TakkTile/takktile-boards/takkarray/usbInterface.brd

## EAGLE design takkarray/usbInterface.brd (2013-01-09)

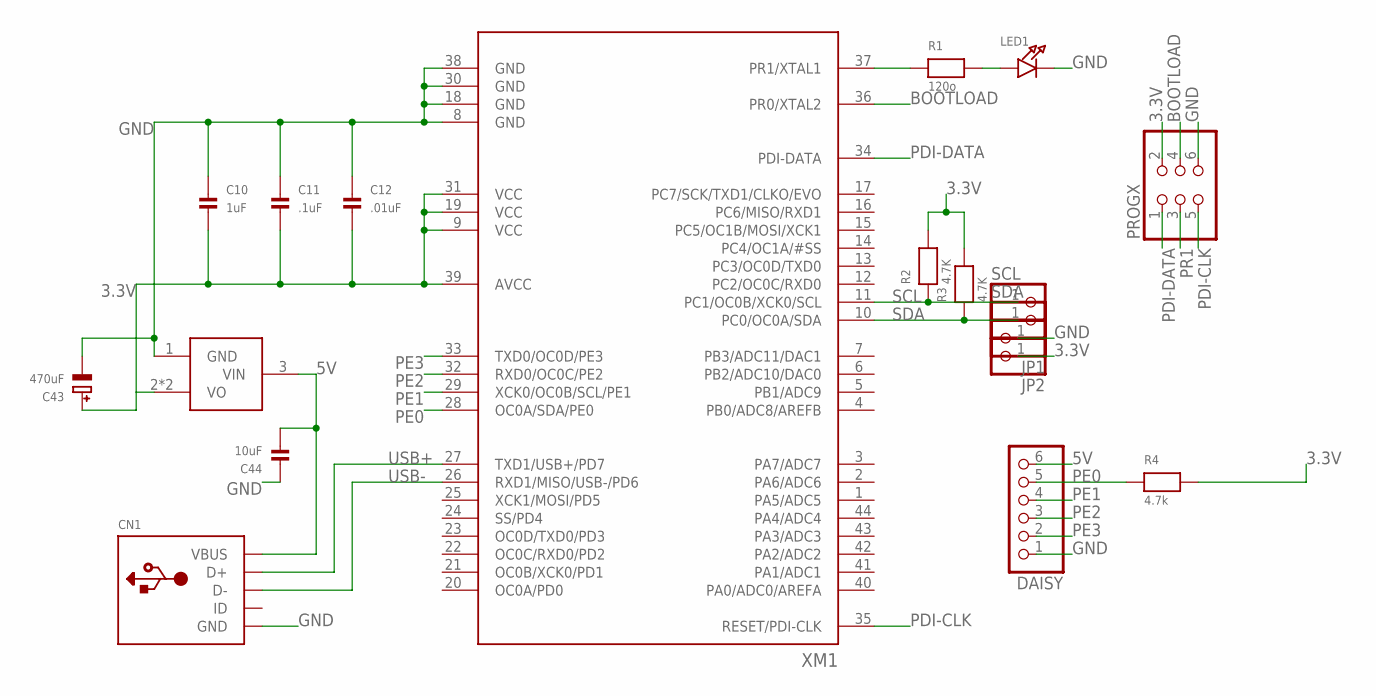
[picture p12: schematic usbInterface.sch]

Parts:
3.3V: VREGAP1117; SOT223
C10: 1uF; 0603
C11: .1uF; 0603
C12: .01uF; 0603
C43: 470uF; EIA7343-31/D-R
C44: 10uF; 1206
CN1: USBMICROB; USB-MICROB
DAISY: HEADER-1X62MM; 1X06_ROUND_2MM
JP1, JP2: HEADER-1X12MM; 1X01_2MM
LED1: LED0603; CHIPLED_0603
PROGX: HEADER-2X3; 2X03
R1: 120o; 0603
R2, R3: 4.7K; 0603
R4: 4.7k; 0603
SCL: HEADER-1X12MM; 1X01_2MM
SDA: HEADER-1X12MM; 1X01_2MM
XM1: ATXMEGAXXA4U-MH; QFN-44

Connections:
3.3V: 3.3V.2 (VO), 3.3V.4 (VO), C10.2, C11.2, C12.2, C43.+, JP2.1, PROGX.2, R2.2, R3.2, R4.2, XM1.9 (VCC), XM1.19 (VCC), XM1.31 (VCC), XM1.39 (AVCC)
5V: 3.3V.3 (VIN), C44.2, CN1.P1 (VBUS), DAISY.6
BOOTLOAD: PROGX.4, XM1.36 (PR0/XTAL2)
GND: 3.3V.1 (GND), C10.1, C11.1, C12.1, C43.-, C44.1, CN1.P5 (GND), DAISY.1, JP1.1, LED1.C, PROGX.6, XM1.8 (GND), XM1.18 (GND), XM1.30 (GND), XM1.38 (GND)
PDI-CLK: PROGX.5, XM1.35 (RESET/PDI-CLK)
PDI-DATA: PROGX.1, XM1.34 (PDI-DATA)
PE0: DAISY.5, R4.1, XM1.28 (OC0A/SDA/PE0)
PE1: DAISY.4, XM1.29 (XCK0/OC0B/SCL/PE1)
PE2: DAISY.3, XM1.32 (RXD0/OC0C/PE2)
PE3: DAISY.2, XM1.33 (TXD0/OC0D/PE3)
PR1: PROGX.3, R1.1, XM1.37 (PR1/XTAL1)
PR1-P: LED1.A, R1.2
SCL: R2.1, SCL.1, XM1.11 (PC1/OC0B/XCK0/SCL)
SDA: R3.1, SDA.1, XM1.10 (PC0/OC0A/SDA)
USB+: CN1.P3 (D+), XM1.27 (TXD1/USB+/PD7)
USB-: CN1.P2 (D-), XM1.26 (RXD1/MISO/USB-/PD6)

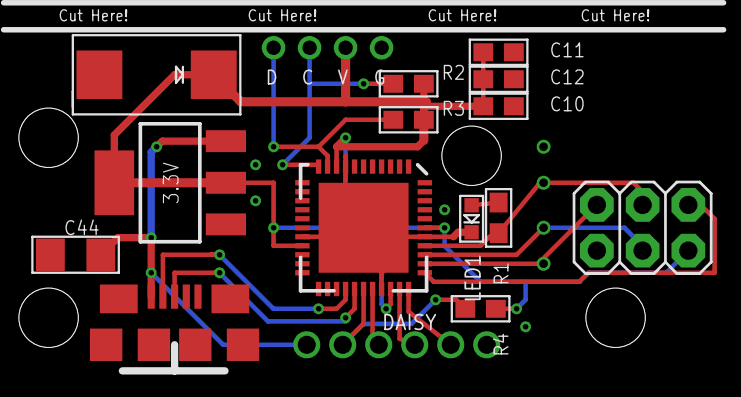
[picture p13: board usbInterface.brd from above]

Board: 2 copper layers, 24 parts (1 on the bottom side), 16 nets.

Other parts of the board:
U$1, U$2, U$3, U$4: STAND-OFF
U$5: LOGO_NONOLITH
