TakkTile/takktile-boards/takkfast/firmware/update.py

#!/usr/bin/python
import sys, os

pathToBootloader = os.path.join(os.path.dirname(__file__), 'usb', 'bootloader')

sys.path.append(pathToBootloader)

from flash import *

time.sleep(.5)

try:
	b = Bootloader()
	b.handle_args(sys.argv)
	exit(0)
except IOError:
	usb.core.find(idVendor=0x59e3, idProduct=0x74C7).ctrl_transfer(0x40|0x80, 0xBB, 0, 0, 1)
	time.sleep(1)
	b = Bootloader()
	b.handle_args(sys.argv)
	exit(0)

print "can't find CEE or xmega in bootloader mode"
exit(2)
