TakkTile/takktile-boards/(commit log)

2012-02-09 initial commit; includes USI-based I2C library and row-zero schematics
    [row0.brd, row0.sch]
2012-02-09 bit more routing
    [row0.brd]
2012-02-09 moved parts to nonolith eagle library, renamed headers
    [row0.brd, row0.sch]
2012-02-17 converted to eagle v6 format, small routing modifications
    [row0.brd, row0.sch]
2012-04-17 compiles for the attiny44 with fuses to run at 8MHz off internal RC osc
2012-04-18 added pindefs from schematic
2012-04-18 added configPins, a bunch of #defines, and code to calculate base I2C address
2012-04-18 oops, had some of my pin #defines backwards.
2012-04-18 replaced base address calculation with more efficient code
    [main.c]
2012-04-19 added eagle stuff
    [roadkill.brd, roadkill.sch, row0.brd, row0.sch]
2012-04-22 fixed fuse def
2012-04-25 programming fuses every time you program the µC is a little tedious...
2012-04-26 port over routed row from dropbox
    [row.brd, row.sch, row0.brd]
2012-04-26 added full 5x8 array
    [fullArray.brd, fullArray.sch]
2012-04-27 invert logic to simplify xmega read/write interrupt issues with QC Enabled
2012-04-27 added support for all-ctrl address, refactored pin control logic to clarify flow
2012-05-03 .8mm hole added
    [row.brd]
2012-05-03 board work.
    [roadkill.brd, roadkill.sch, row.brd]
2012-05-03 fixed power draw issues...
    [main.c]
2012-05-24 Connected vertically stacked boards
    Full 8-vertical layout now has power and SPI lines connected betwble een
    boards.
    Added the tessellatable layout go make arbitrarily high stacks.
    [fullArray.brd, fullArray.sch, tessellate.brd, tessellate.sch]
2012-05-31 added masked pads for 3.3v, gnd, sda, and scl. changed vias from circular to octogonal to help spacing.
    [tessellate.brd]
2012-06-01 added labels to breakout pins, moved pin1 indicators on freescale sensors to closer to pad
    [tessellate.brd]
2012-06-03 initial commit of usb interface
    [usb-interface.brd, usb-interface.sch]
2012-06-03 move to tPlace
    [tessellate.sch]
2012-06-04 major rework of usb interface board - dropped Y by 5mm, cleaned routing, added better mounting.
    [usb-interface.brd, usb-interface.sch]
2012-06-04 killed Dimension layer on the tessellateable board
    [tessellate.brd]
2012-06-06 reworked silkscreen and snap on tesselate.brd
    [tessellate.brd, tessellate.sch, usb-interface.brd]
2012-06-06 tweak silkscreening - turns out eagle can write the 'align' attr, but not read it...
    [tessellate.brd]
2012-06-06 added four row board w/ USB interface.
    [fullArray.brd, fullArray.sch]
2012-06-06 silkscreen tweaks.
    [fullArray.brd]
2012-06-06 square up mounting holes
    [fullArray.brd]
2012-06-06 full 8 rows with standardized naming
    [fullArray.brd, fullArray.sch]
2012-06-06 now with proper address pin configurations
    [fullArray.brd, fullArray.sch]
2012-06-06 fixed few ERC glitches and ADDR routing
    [fullArray.brd, fullArray.sch]
2012-06-06 removed unimaginative row
    [row.brd, row.sch]
2012-06-06 removed roadkill
    [roadkill.brd, roadkill.sch]
2012-06-06 fixed few drc issues w/ ground traces too close to addr pins
    [fullArray.brd]
2012-06-06 goodbye airwires
    [fullArray.brd]
2012-06-06 fix silkscreen outline of attiny
    [fullArray.brd, fullArray.sch]
2012-06-06 extend silkscreen line
    [fullArray.brd]
2012-06-06 a bit of branding.
    [fullArray.brd]
2012-06-06 added cut line on bottom of PCB
    [fullArray.brd]
2012-06-08 added www.biorobotics.harvard.edu/takktile
    [fullArray.brd]
2012-06-08 added values for all the things
    [fullArray.brd, fullArray.sch]
2012-06-08 small tweaks to naming - filled in C15 and fixed PROGX
    [fullArray.brd, fullArray.sch]
2012-06-08 added BOM
    [fullArray.BOM.csv]
2012-06-13 updated to match nonolith.lbr
    [fullArray.brd, fullArray.sch]
2012-06-13 part not MMH, part MH
    [fullArray.brd, fullArray.sch]
2012-06-13 removed old CSV, added new .xls and pdf
    [fullArray.BOM.xls]
2012-06-19 fixed silkscreen branding, changed from mil to mm
    [fullArray.brd]
2012-06-19 squared silkscreen branding
    [fullArray.brd]
2012-06-19 modified with demarcated cut lines for separating the USB interface board from the array
    [fullArray.brd]
2012-06-29 added usb-interface from fullArray
    [usb-interface.brd, usb-interface.sch]
2012-06-29 rename to match camelCase conventions
    [usbInterface.brd, usbInterface.sch]
2012-07-21 'make program' now actually flashes fuses and firmware
2012-07-23 change cell indexing from 2d to 1d
    [fullArray.brd, fullArray.sch]
2012-07-23 zero-index slaveAddress, set 0x0e as allcall, fix comment formatting, general forward progress
    [main.c]
2012-07-24 right. fixed math error.
    [main.c]
2012-11-10 comment, enable BOD @ 2.7v
2012-12-02 redo power section and host interface part of board
    [fullArray.brd, fullArray.sch]
2012-12-02 start of repeatable / chainable rows w/ 7mm spacing and no vias under qfn tiny
    [tessellate.brd, tessellate.sch]
2012-12-03 add 1206 decoupling capacitor to 5v0 supply
    [fullArray.brd, fullArray.sch]
2013-01-04 major rework of tesselate file - needs a tiny bit of tweaking for full tesselation
    [tessellate.brd, tessellate.sch]
2013-01-04 add 7mm center-to-center ground pour on bottom
    [tessellate.brd]
2013-01-04 should tesselate now. I am excite.
    [tessellate.brd]
2013-01-04 one index sensors
    [tessellate.brd, tessellate.sch]
2013-01-07 straighten between-row lines to facilitate maximally tight spacing
    [tessellate.brd]
2013-01-07 add via for continuous ground pour
    [tessellate.brd]
2013-01-07 6mm row-row spacing, numbers at top of sensor, should be good to go for tesselation
    [tessellate.brd]
2013-01-07 align traces for tessellation. hopefully the last modification needed to this board...
    [tessellate.brd]
2013-01-08 explicit ground connections, remove bothersome ground via
    [tessellate.brd]
2013-01-09 rename some signals and stuff
    [tessellate.brd, tessellate.sch]
2013-01-09 added up to date usb interface board
    [usbInterface.brd, usbInterface.sch]
2013-01-09 fix numbering scheme for tesselation
    [tessellate.brd, tessellate.sch]
2013-01-09 need to tweak address pins, but should be manufacturable
    [fullArray.brd, fullArray.sch]
2013-01-09 no airwires save address pins
    [fullArray.brd, fullArray.sch]
2013-01-09 fixed addressing logic pin assignment, zero airwires, zero todos
    [fullArray.brd, fullArray.sch]
2013-01-09 cosmetic rearrangements, drop programming header on xmega, center board
    [fullArray.brd, fullArray.sch]
2013-01-09 center, center, and recenter...
    [fullArray.brd]
2013-01-09 shorten board by 2mm, move mounting holes in
    [fullArray.brd]
2013-01-10 drop 4-40 header holes for 2.4mm holes, clean a few dimensions
    [fullArray.brd]
2013-01-10 once again, tweak the outline.
    [fullArray.brd]
2013-01-10 added branding, version number, and reorganized 4 lines out of USB array to match layout on board
    [fullArray.brd]
2013-01-10 s/proportional font/vector font/, move a few traces to 45deg
    [fullArray.brd]
2013-01-18 initial commit of naive multi-sample addressing code; use shifter & accumulator to average eight calls of getAddress();
2013-02-10 1) Addresing problem was fixed 2) Dedicated code for TakkTile addressing was included
    [main.c]
2013-03-04 s/0603 resistor/solder jumper/, clean power traces, add 0.5mm vias for PDI-DATA and PDI-CLK
    [fullArray.brd, fullArray.sch]
2013-11-19 restructuring folders
    [fullArray.BOM.xls, fullArray.brd, fullArray.sch, tessellate.brd, tessellate.sch, usbInterface.brd, usbInterface.sch]
2013-12-10 reorganized repo by board
    [fullArray.BOM.xls, fullArray.brd, fullArray.sch, tessellate.brd, tessellate.sch, usbInterface.brd, usbInterface.sch]
2013-12-10 added 6-sensor addressing
